kendrick010/enigma/README.md

# enigma

A 65% through-hole keyboard inspired by the Discipline V2 and Nibble keyboard.

The keyboard is flashed using QMK Toolbox.
