kendrick010/enigma/preview/command1.png

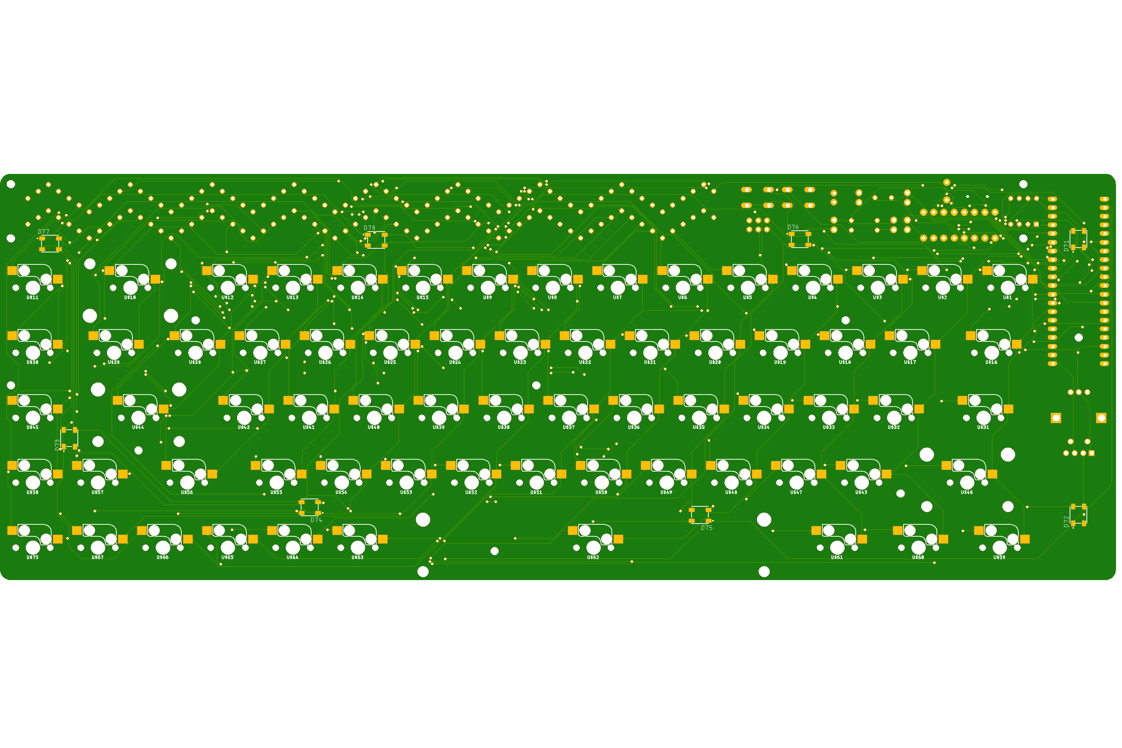
preview/command1.png
