kendrick010/enigma/preview/command2.png

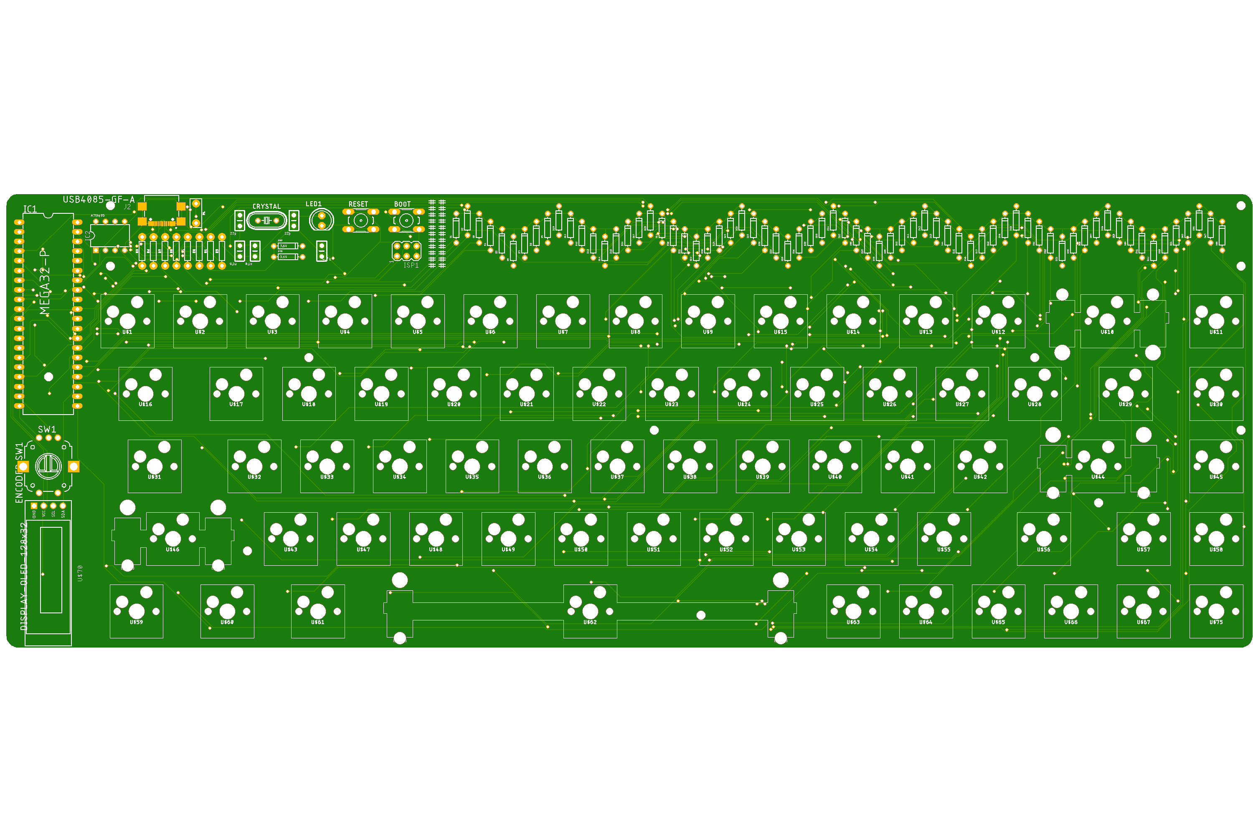
preview/command2.png
