kendrick010/enigma/models/assembly.step

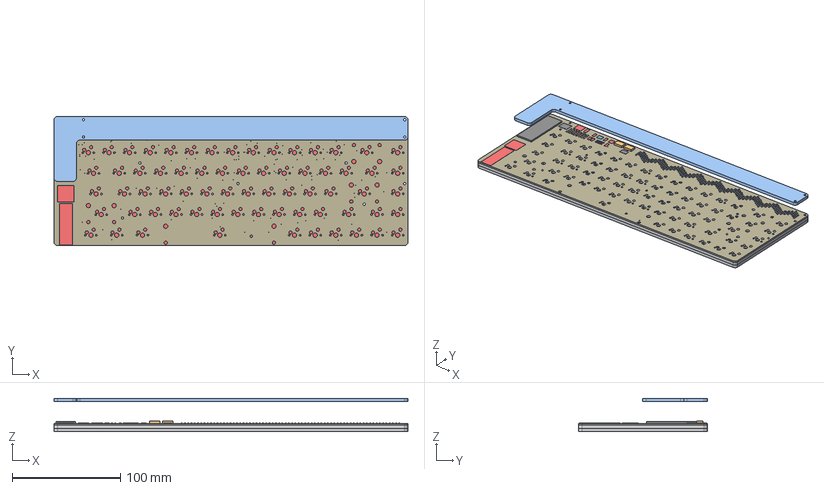
[picture p3: CAD file, 2021-10-31]
models/assembly.step
327.0 x 119.1 x 30.6 mm
acrylic_guard
bottom_acrylic
Board
HC49U-V
DO-1N4148 x 70
DIL40
AVRISP
LED5MM
AXIAL-0.3 x 8
B3F-10XX x 2
PEC12_INCREMENTAL_ENCODER
MXHSPCB-1U x 64
MXHSPCB-2U
MXHSPCB-2U-FLIPPED x 2
MXHSPCB-6.25U-FLIPPED
CAP-TH x 5
DISPLAY-OLED-128X32
DIL08
LED_1655 x 8
GCT_USB4110-GF-A_REVB
PTH
stacked_acrylic
