kendrick010/enigma/models/acrylic_guard.step

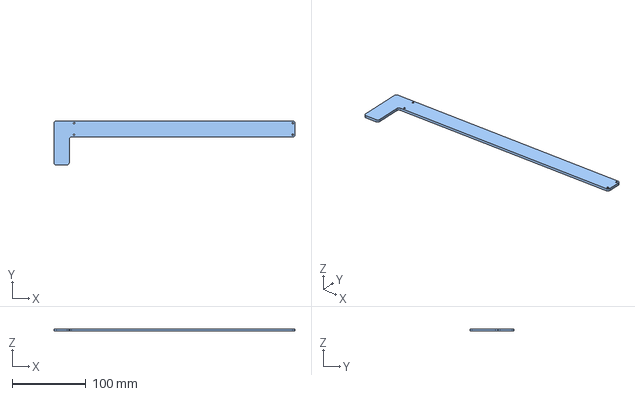
[picture p4: CAD file, 2021-10-31]
models/acrylic_guard.step
327.0 x 59.9 x 3.00 mm
