kendrick010/enigma/models/bottom_acrylic.step

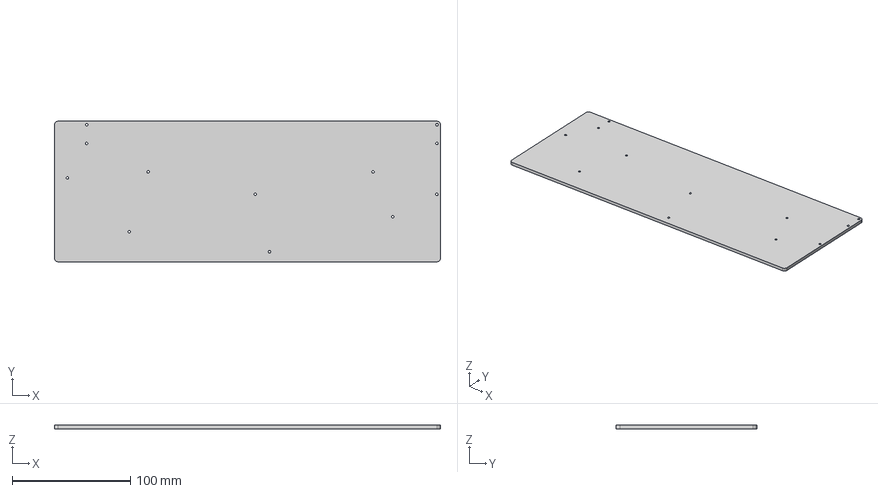
[picture p5: CAD file, 2021-10-31]
models/bottom_acrylic.step
327.0 x 119.1 x 3.00 mm
