kendrick010/enigma/models/stacked_acrylic.step

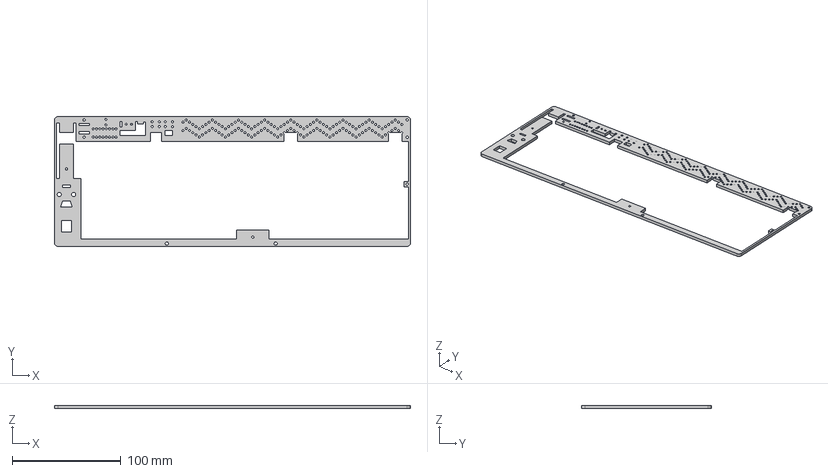
[picture p7: CAD file, 2021-10-31]
models/stacked_acrylic.step
327.0 x 119.1 x 3.00 mm
