kendrick010/enigma/acrylic_parts/acrylic_guard.pdf

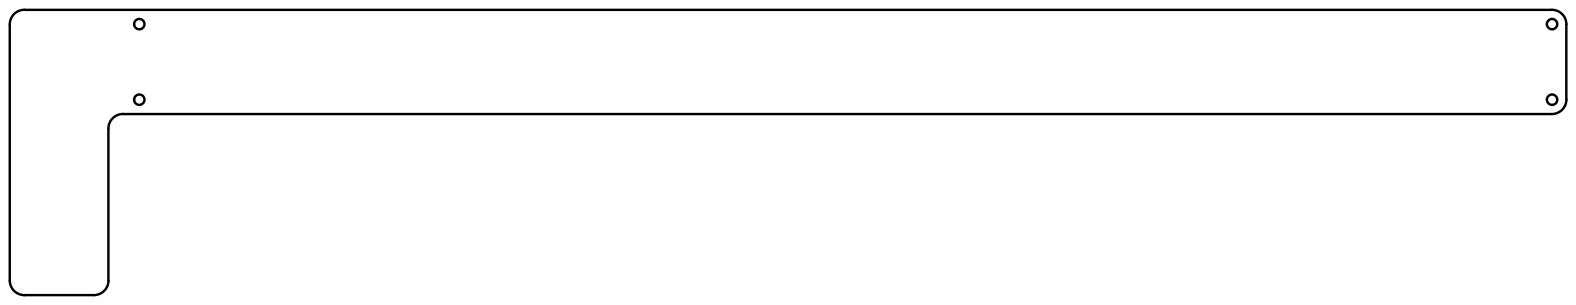
[picture p8: page 1]
