kendrick010/enigma/acrylic_parts/bottom_acrylic.pdf

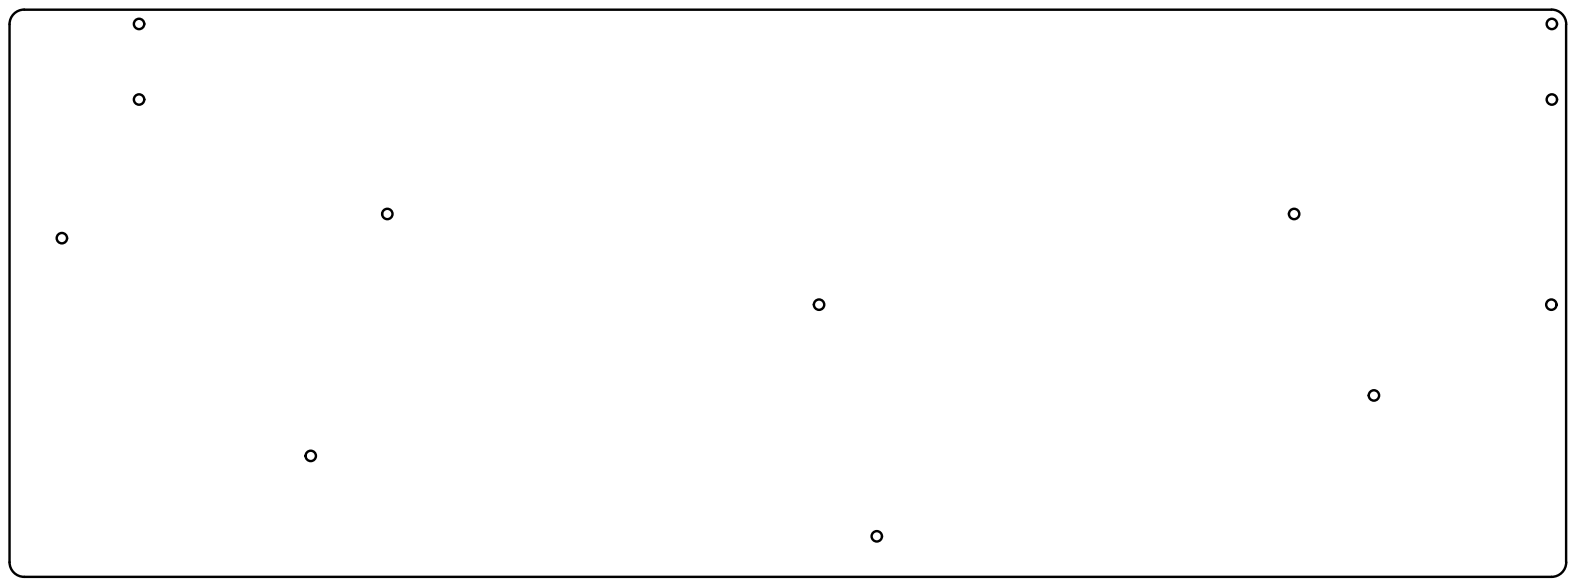
[picture p9: page 1]
