kendrick010/enigma/acrylic_parts/stacked_acrylic.pdf

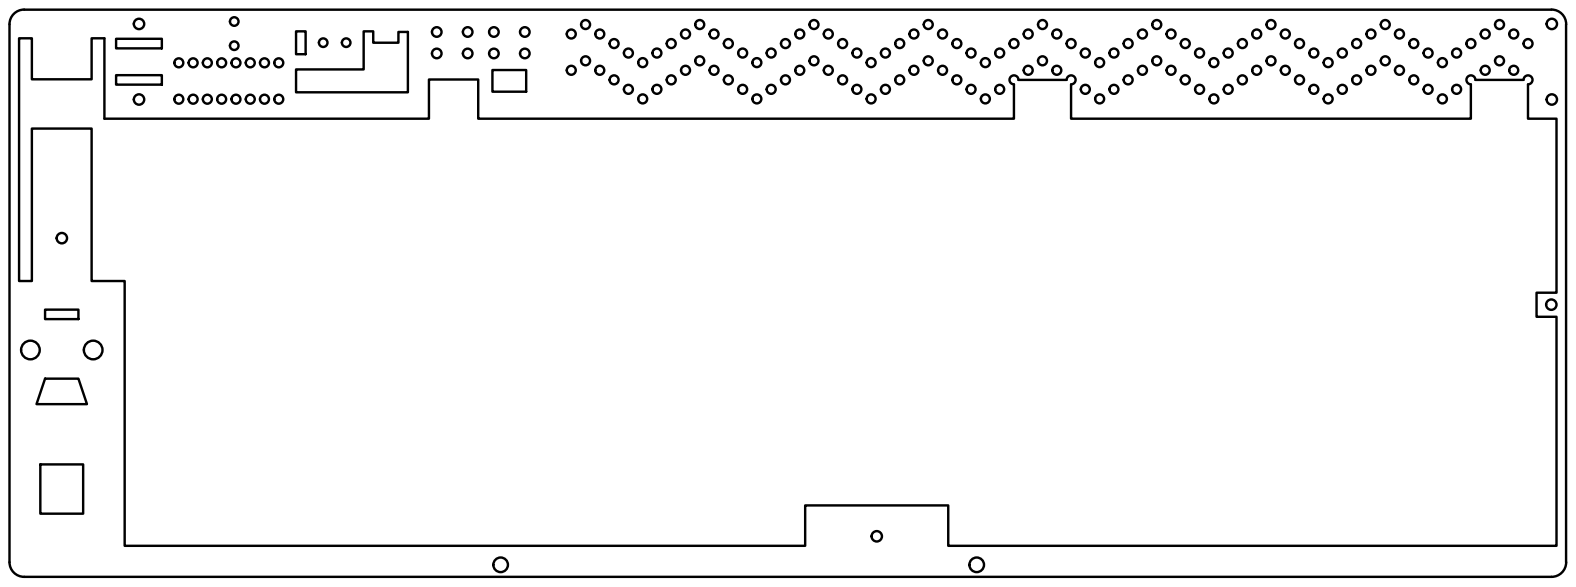
[picture p10: page 1]
