kendrick010/enigma/enigma.brd

## EAGLE design enigma.brd (2021-10-31)

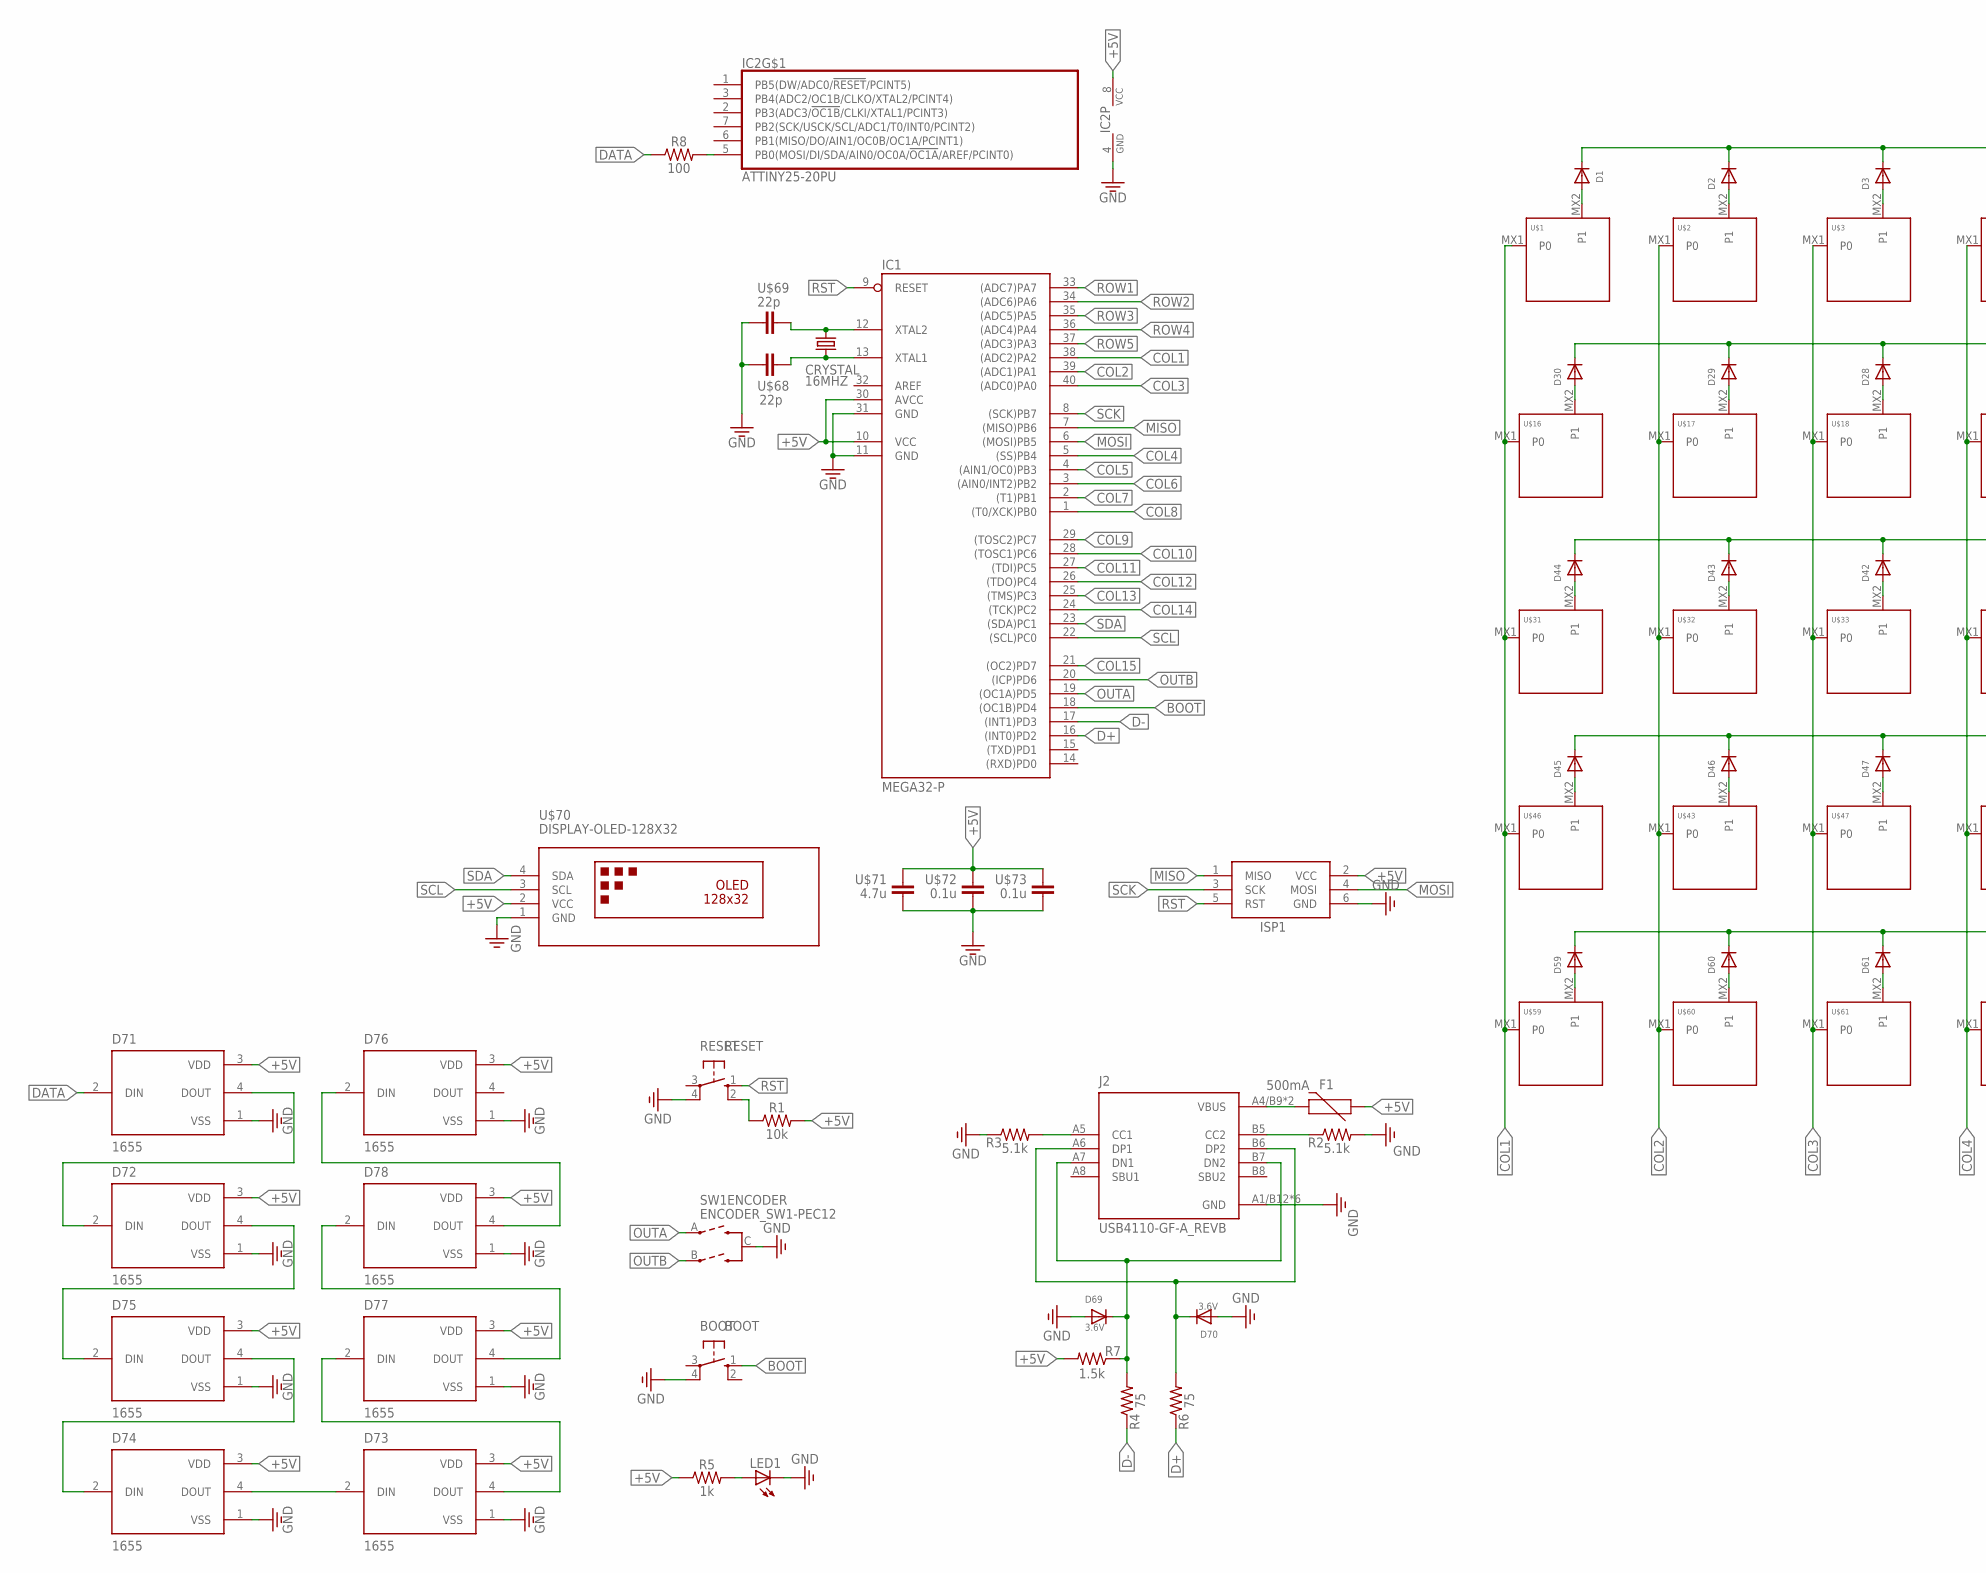
[picture p11: schematic enigma.sch, part in row 1, column 1]

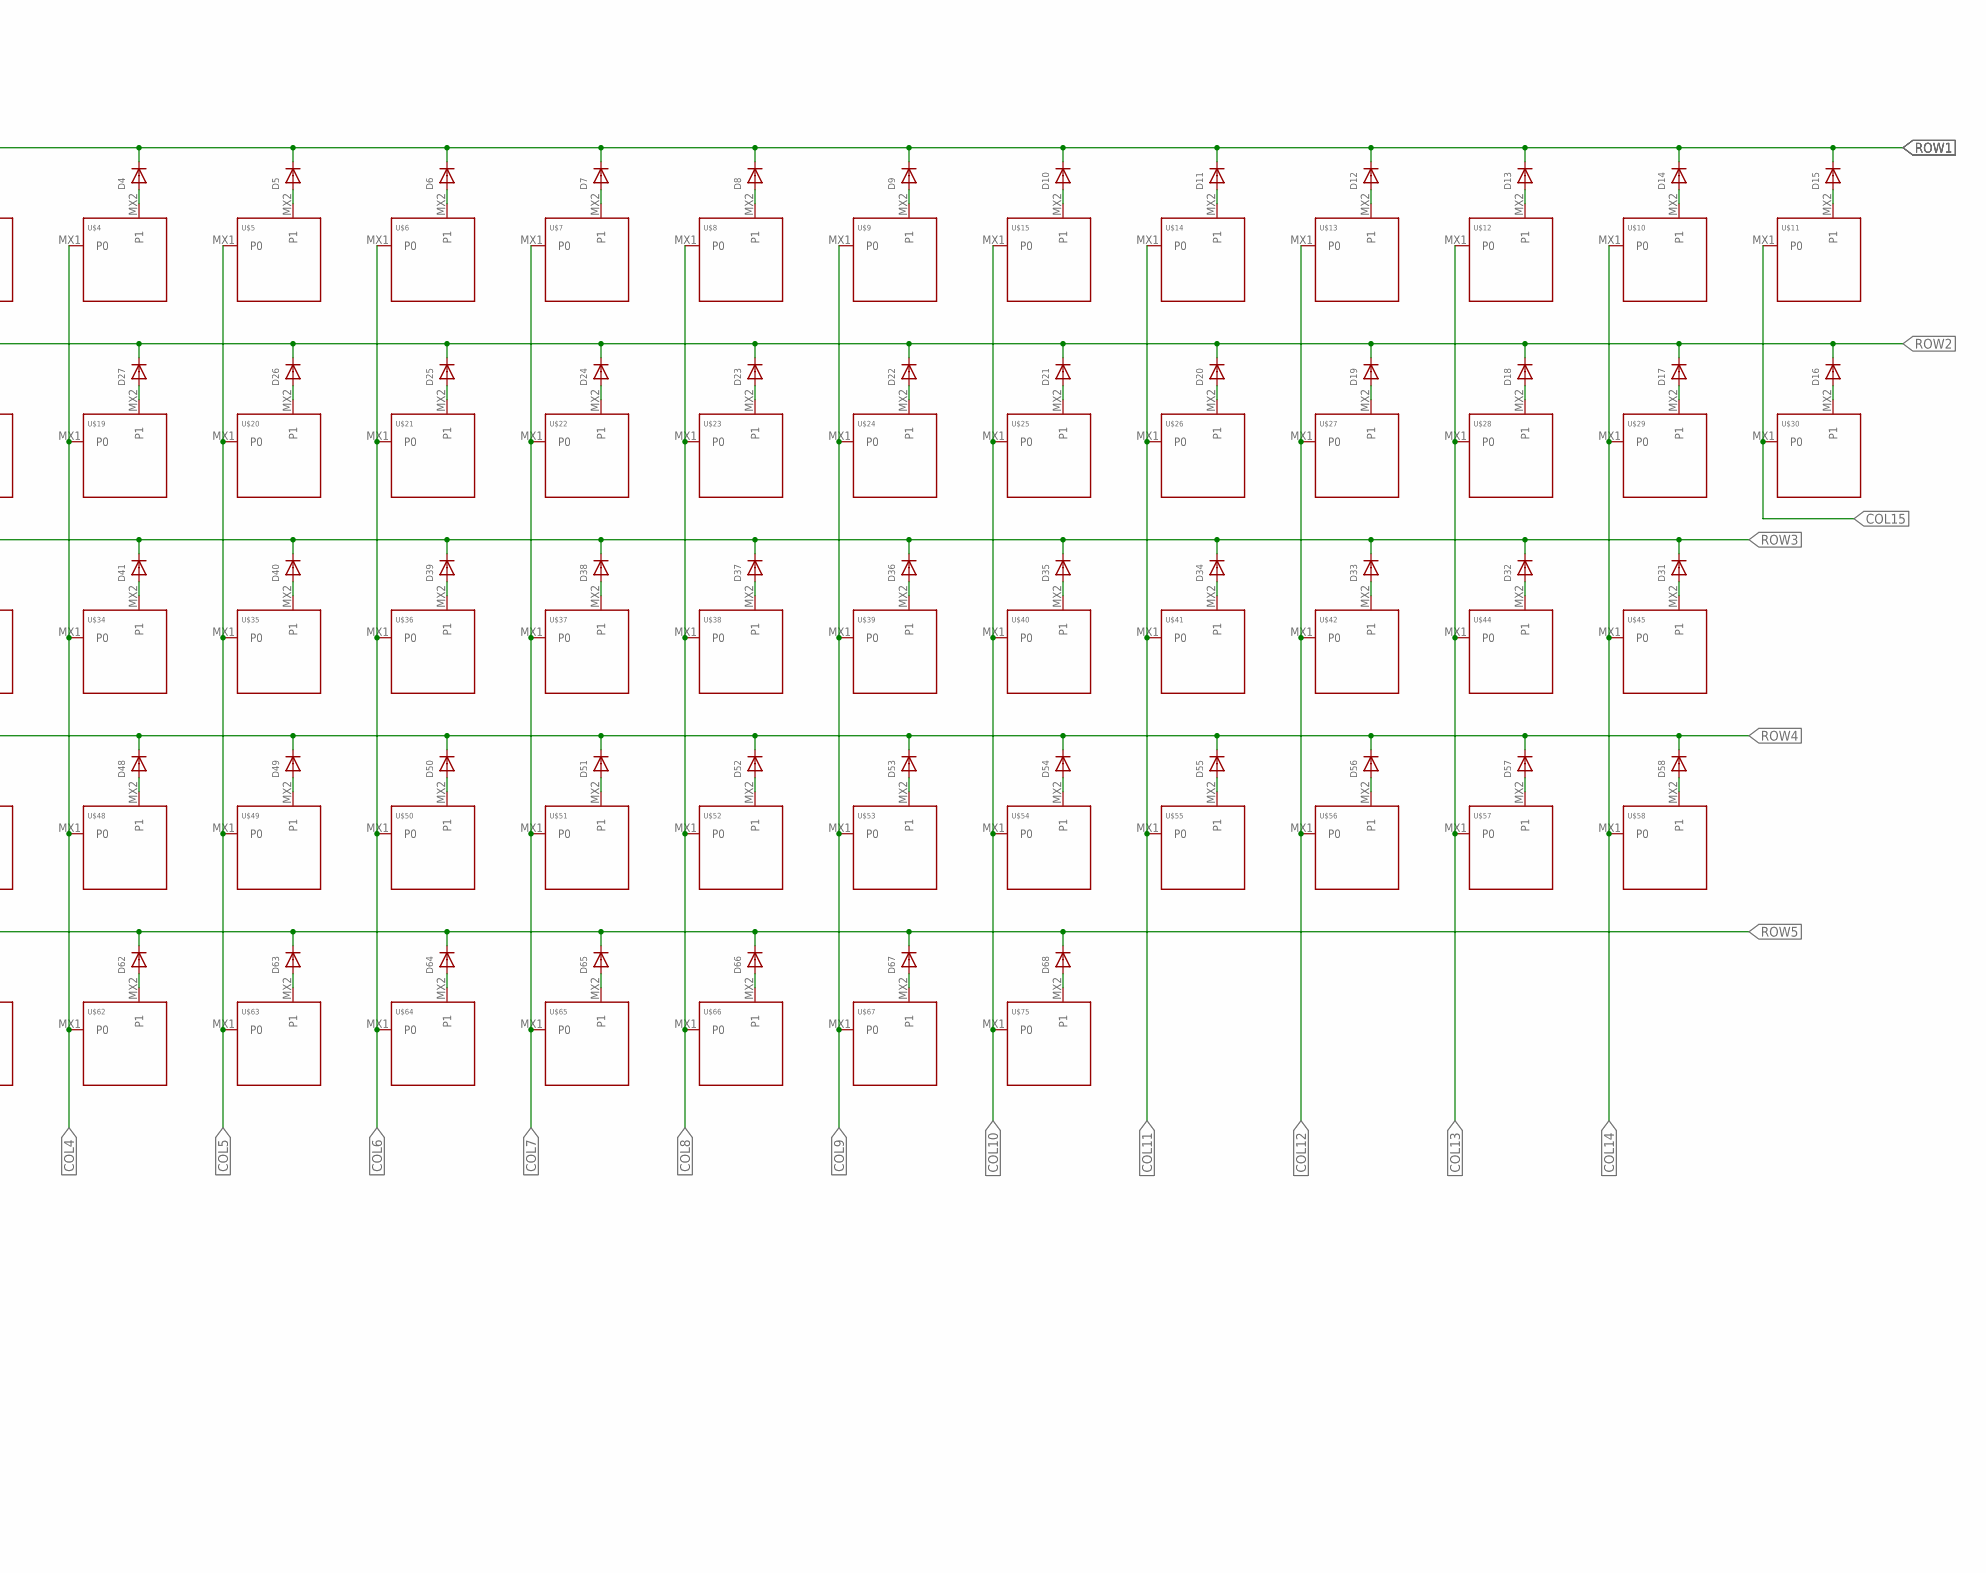
[picture p12: schematic enigma.sch, part in row 1, column 2]

Parts:
BOOT: BOOT; B3F-10XX
CRYSTAL: 16MHZ; HC49U-V
D1, D2, D3, D4, D5, D6, D7, D8, D9, D10, D11, D12, D13, D14, D15, D16, D17, D18, D19, D20, D21, D22, D23, D24, D25, D26, D27, D28, D29, D30, D31, D32, D33, D34, D35, D36, D37, D38, D39, D40, D41, D42, D43, D44, D45, D46, D47, D48, D49, D50, D51, D52, D53, D54, D55, D56, D57, D58, D59, D60, D61, D62, D63, D64, D65, D66, D67, D68: DIODEDO-1N4148; DO-1N4148
D69, D70: 3.6V; DO-1N4148
D71, D72, D73, D74, D75, D76, D77, D78: 1655; LED_1655
F1: 500mA; PTH
IC1: MEGA32-P; DIL40
IC2: ATTINY25-20PU; DIL08
ISP1: AVRISP-6; AVRISP
J2: USB4110-GF-A_REVB; GCT_USB4110-GF-A_REVB
LED1: LED5MM
R1: 10k; AXIAL-0.3
R2, R3: 5.1k; AXIAL-0.3
R4, R6: 75; AXIAL-0.3
R5: 1k; AXIAL-0.3
R7: 1.5k; AXIAL-0.3
R8: 100; AXIAL-0.3
RESET: RESET; B3F-10XX
SW1: ENCODER_SW1-PEC12; PEC12_INCREMENTAL_ENCODER
U$1, U$2, U$3, U$4, U$5, U$6, U$7, U$8, U$9, U$11, U$12, U$13, U$14, U$15, U$16, U$17, U$18, U$19, U$20, U$21, U$22, U$23, U$24, U$25, U$26, U$27, U$28, U$29, U$30, U$31, U$32, U$33, U$34, U$35, U$36, U$37, U$38, U$39, U$40, U$41, U$42, U$43, U$45, U$47, U$48, U$49, U$50, U$51, U$52, U$53, U$54, U$55, U$56, U$57, U$58, U$59, U$60, U$61, U$63, U$64, U$65, U$66, U$67, U$75: KEYSWITCH-PLAIN-MXHSPCB-1U; MXHSPCB-1U
U$10: KEYSWITCH-PLAIN-MXHSPCB-2U; MXHSPCB-2U
U$44, U$46: KEYSWITCH-PLAIN-MXHSPCB-2U-FLIPPED; MXHSPCB-2U-FLIPPED
U$62: KEYSWITCH-PLAIN-MXHSPCB-6.25U-FLIPPED; MXHSPCB-6.25U-FLIPPED
U$68, U$69: 22p; CAP-TH
U$70: DISPLAY-OLED-128X32
U$71: 4.7u; CAP-TH
U$72, U$73: 0.1u; CAP-TH

Connections:
3.3V: BOOT.4 (P1), D69.A, D70.A, D71.1 (VSS), D72.1 (VSS), D73.1 (VSS), D74.1 (VSS), D75.1 (VSS), D76.1 (VSS), D77.1 (VSS), D78.1 (VSS), IC1.11 (GND), IC1.31 (GND), IC2.4 (GND), ISP1.6 (GND), J2.A1/B12 (GND), J2.B1/A12 (GND), J2.S1 (GND), J2.S2 (GND), J2.S3 (GND), J2.S4 (GND), LED1.K (C), R2.P$2 (2), R3.P$1 (1), RESET.4 (P1), SW1.C, U$68.2, U$69.1, U$70.1 (GND), U$71.1, U$72.1, U$73.1
+5V: D71.3 (VDD), D72.3 (VDD), D73.3 (VDD), D74.3 (VDD), D75.3 (VDD), D76.3 (VDD), D77.3 (VDD), D78.3 (VDD), F1.P$1 (1), IC1.10 (VCC), IC1.30 (AVCC), IC2.8 (VCC), ISP1.2 (VCC), R1.P$2 (2), R5.P$1 (1), R7.P$2 (2), U$70.2 (VCC), U$71.2, U$72.2, U$73.2
BOOT: BOOT.1 (S), IC1.18 ((OC1B)PD4)
COL1: IC1.38 ((ADC2)PA2), U$1.MX1 (P0), U$16.MX1 (P0), U$31.MX1 (P0), U$46.MX1 (P0), U$59.MX1 (P0)
COL2: IC1.39 ((ADC1)PA1), U$2.MX1 (P0), U$17.MX1 (P0), U$32.MX1 (P0), U$43.MX1 (P0), U$60.MX1 (P0)
COL3: IC1.40 ((ADC0)PA0), U$3.MX1 (P0), U$18.MX1 (P0), U$33.MX1 (P0), U$47.MX1 (P0), U$61.MX1 (P0)
COL4: IC1.5 ((SS)PB4), U$4.MX1 (P0), U$19.MX1 (P0), U$34.MX1 (P0), U$48.MX1 (P0), U$62.MX1 (P0)
COL5: IC1.4 ((AIN1/OC0)PB3), U$5.MX1 (P0), U$20.MX1 (P0), U$35.MX1 (P0), U$49.MX1 (P0), U$63.MX1 (P0)
COL6: IC1.3 ((AIN0/INT2)PB2), U$6.MX1 (P0), U$21.MX1 (P0), U$36.MX1 (P0), U$50.MX1 (P0), U$64.MX1 (P0)
COL7: IC1.2 ((T1)PB1), U$7.MX1 (P0), U$22.MX1 (P0), U$37.MX1 (P0), U$51.MX1 (P0), U$65.MX1 (P0)
COL8: IC1.1 ((T0/XCK)PB0), U$8.MX1 (P0), U$23.MX1 (P0), U$38.MX1 (P0), U$52.MX1 (P0), U$66.MX1 (P0)
COL9: IC1.29 ((TOSC2)PC7), U$9.MX1 (P0), U$24.MX1 (P0), U$39.MX1 (P0), U$53.MX1 (P0), U$67.MX1 (P0)
COL10: IC1.28 ((TOSC1)PC6), U$15.MX1 (P0), U$25.MX1 (P0), U$40.MX1 (P0), U$54.MX1 (P0), U$75.MX1 (P0)
COL11: IC1.27 ((TDI)PC5), U$14.MX1 (P0), U$26.MX1 (P0), U$41.MX1 (P0), U$55.MX1 (P0)
COL12: IC1.26 ((TDO)PC4), U$13.MX1 (P0), U$27.MX1 (P0), U$42.MX1 (P0), U$56.MX1 (P0)
COL13: IC1.25 ((TMS)PC3), U$12.MX1 (P0), U$28.MX1 (P0), U$44.MX1 (P0), U$57.MX1 (P0)
COL14: IC1.24 ((TCK)PC2), U$10.MX1 (P0), U$29.MX1 (P0), U$45.MX1 (P0), U$58.MX1 (P0)
COL15: IC1.21 ((OC2)PD7), U$11.MX1 (P0), U$30.MX1 (P0)
D+: IC1.16 ((INT0)PD2), R6.P$1 (1)
D-: IC1.17 ((INT1)PD3), R4.P$1 (1)
DATA: D71.2 (DIN), R8.P$1 (1)
MISO: IC1.7 ((MISO)PB6), ISP1.1 (MISO)
MOSI: IC1.6 ((MOSI)PB5), ISP1.4 (MOSI)
unnamed: D1.A, U$1.MX2 (P1)
unnamed: D2.A, U$2.MX2 (P1)
unnamed: D3.A, U$3.MX2 (P1)
unnamed: D4.A, U$4.MX2 (P1)
unnamed: D5.A, U$5.MX2 (P1)
unnamed: D6.A, U$6.MX2 (P1)
unnamed: D7.A, U$7.MX2 (P1)
unnamed: D8.A, U$8.MX2 (P1)
unnamed: D9.A, U$9.MX2 (P1)
unnamed: D10.A, U$15.MX2 (P1)
unnamed: D11.A, U$14.MX2 (P1)
unnamed: D12.A, U$13.MX2 (P1)
unnamed: D13.A, U$12.MX2 (P1)
unnamed: D14.A, U$10.MX2 (P1)
unnamed: D15.A, U$11.MX2 (P1)
unnamed: D30.A, U$16.MX2 (P1)
unnamed: D29.A, U$17.MX2 (P1)
unnamed: D28.A, U$18.MX2 (P1)
unnamed: D27.A, U$19.MX2 (P1)
unnamed: D26.A, U$20.MX2 (P1)
unnamed: D25.A, U$21.MX2 (P1)
unnamed: D24.A, U$22.MX2 (P1)
unnamed: D23.A, U$23.MX2 (P1)
unnamed: D22.A, U$24.MX2 (P1)
unnamed: D21.A, U$25.MX2 (P1)
unnamed: D20.A, U$26.MX2 (P1)
unnamed: D19.A, U$27.MX2 (P1)
unnamed: D18.A, U$28.MX2 (P1)
unnamed: D17.A, U$29.MX2 (P1)
unnamed: D16.A, U$30.MX2 (P1)
unnamed: D44.A, U$31.MX2 (P1)
unnamed: D43.A, U$32.MX2 (P1)
unnamed: D42.A, U$33.MX2 (P1)
unnamed: D41.A, U$34.MX2 (P1)
unnamed: D40.A, U$35.MX2 (P1)
unnamed: D39.A, U$36.MX2 (P1)
unnamed: D38.A, U$37.MX2 (P1)
unnamed: D37.A, U$38.MX2 (P1)
unnamed: D36.A, U$39.MX2 (P1)
unnamed: D35.A, U$40.MX2 (P1)
unnamed: D34.A, U$41.MX2 (P1)
unnamed: D33.A, U$42.MX2 (P1)
unnamed: D32.A, U$44.MX2 (P1)
unnamed: D31.A, U$45.MX2 (P1)
unnamed: D45.A, U$46.MX2 (P1)
unnamed: D46.A, U$43.MX2 (P1)
unnamed: D47.A, U$47.MX2 (P1)
unnamed: D48.A, U$48.MX2 (P1)
unnamed: D49.A, U$49.MX2 (P1)
unnamed: D50.A, U$50.MX2 (P1)
unnamed: D51.A, U$51.MX2 (P1)
unnamed: D52.A, U$52.MX2 (P1)
unnamed: D53.A, U$53.MX2 (P1)
unnamed: D54.A, U$54.MX2 (P1)
unnamed: D55.A, U$55.MX2 (P1)
unnamed: D56.A, U$56.MX2 (P1)
unnamed: D57.A, U$57.MX2 (P1)
unnamed: D58.A, U$58.MX2 (P1)
unnamed: D67.A, U$67.MX2 (P1)
unnamed: D66.A, U$66.MX2 (P1)
unnamed: D65.A, U$65.MX2 (P1)
unnamed: D64.A, U$64.MX2 (P1)
unnamed: D63.A, U$63.MX2 (P1)
unnamed: D62.A, U$62.MX2 (P1)
unnamed: D61.A, U$61.MX2 (P1)
unnamed: D60.A, U$60.MX2 (P1)
unnamed: D68.A, U$75.MX2 (P1)
unnamed: CRYSTAL.1, IC1.12 (XTAL2), U$69.2
unnamed: CRYSTAL.2, IC1.13 (XTAL1), U$68.1
unnamed: D59.A, U$59.MX2 (P1)
unnamed: F1.P$2 (2), J2.A4/B9 (VBUS), J2.B4/A9 (VBUS)
unnamed: J2.B5 (CC2), R2.P$1 (1)
unnamed: J2.A5 (CC1), R3.P$2 (2)
unnamed: D69.C, J2.A7 (DN1), J2.B7 (DN2), R4.P$2 (2), R7.P$1 (1)
unnamed: LED1.A, R5.P$2 (2)
unnamed: R1.P$1 (1), RESET.2 (S1)
unnamed: IC2.5 (PB0(MOSI/DI/SDA/AIN0/OC0A/!OC1A!/AREF/P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), R8.P$2 (2)
unnamed: D71.4 (DOUT), D72.2 (DIN)
unnamed: D70.C, J2.A6 (DP1), J2.B6 (DP2), R6.P$2 (2)
unnamed: D72.4 (DOUT), D75.2 (DIN)
unnamed: D74.2 (DIN), D75.4 (DOUT)
unnamed: D73.2 (DIN), D74.4 (DOUT)
unnamed: D73.4 (DOUT), D77.2 (DIN)
unnamed: D77.4 (DOUT), D78.2 (DIN)
unnamed: D76.2 (DIN), D78.4 (DOUT)
OUTA: IC1.19 ((OC1A)PD5), SW1.A
OUTB: IC1.20 ((ICP)PD6), SW1.B
ROW1: D1.C, D2.C, D3.C, D4.C, D5.C, D6.C, D7.C, D8.C, D9.C, D10.C, D11.C, D12.C, D13.C, D14.C, D15.C, IC1.33 ((ADC7)PA7)
ROW2: D16.C, D17.C, D18.C, D19.C, D20.C, D21.C, D22.C, D23.C, D24.C, D25.C, D26.C, D27.C, D28.C, D29.C, D30.C, IC1.34 ((ADC6)PA6)
ROW3: D31.C, D32.C, D33.C, D34.C, D35.C, D36.C, D37.C, D38.C, D39.C, D40.C, D41.C, D42.C, D43.C, D44.C, IC1.35 ((ADC5)PA5)
ROW4: D45.C, D46.C, D47.C, D48.C, D49.C, D50.C, D51.C, D52.C, D53.C, D54.C, D55.C, D56.C, D57.C, D58.C, IC1.36 ((ADC4)PA4)
ROW5: D59.C, D60.C, D61.C, D62.C, D63.C, D64.C, D65.C, D66.C, D67.C, D68.C, IC1.37 ((ADC3)PA3)
RST: IC1.9 (RESET), ISP1.5 (RST), RESET.1 (S)
SCK: IC1.8 ((SCK)PB7), ISP1.3 (SCK)
SCL: IC1.22 ((SCL)PC0), U$70.3 (SCL)
SDA: IC1.23 ((SDA)PC1), U$70.4 (SDA)

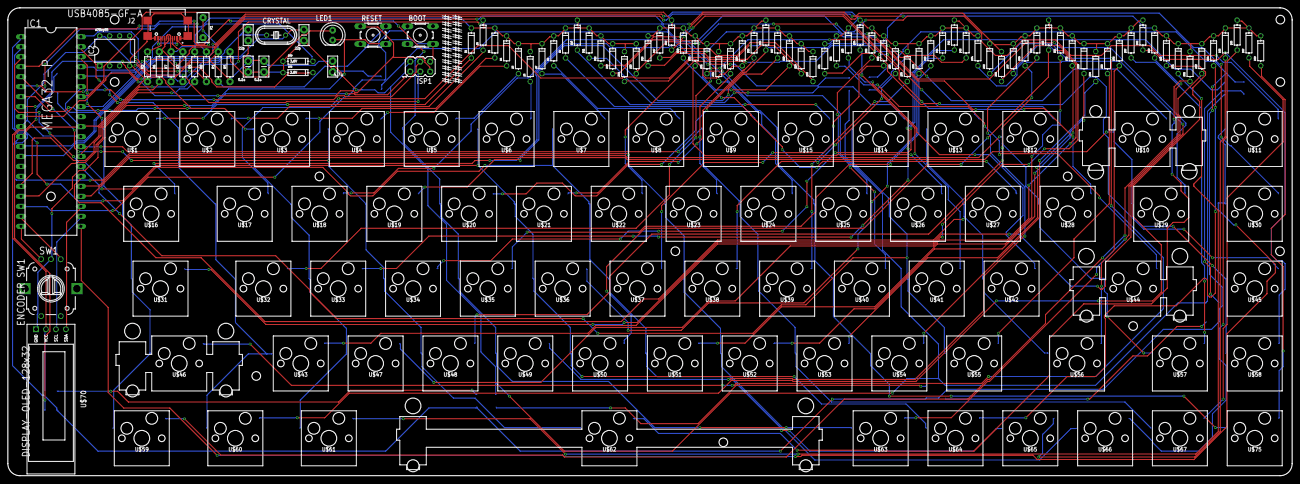
[picture p13: board enigma.brd from above]

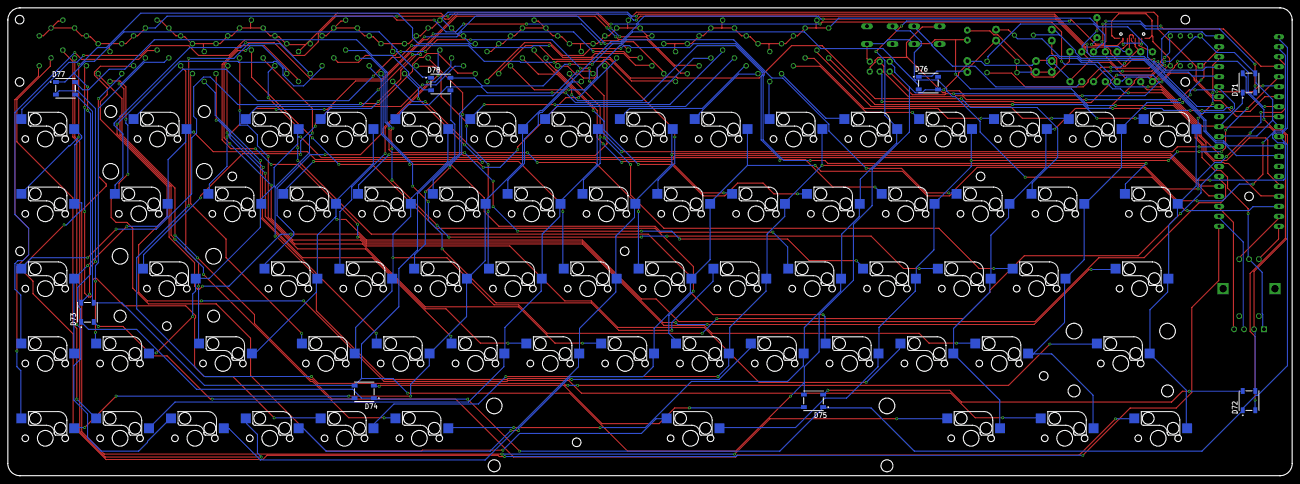
[picture p14: board enigma.brd from below]

Board: 2 copper layers, 327.0 x 119.1 mm, 170 parts (76 on the bottom side), 119 nets.
